HCI-Lab-Saarland/Print-A-Sketch/3d-print/3mf/case_CAMERABOARD.3mf

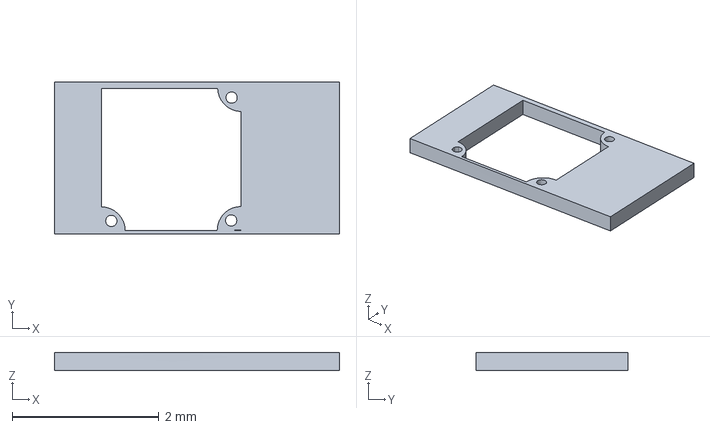
[picture p1: CAD file, 2022-02-14]
3d-print/3mf/case_CAMERABOARD.3mf
3.88 x 2.07 x 0.25 mm
