HCI-Lab-Saarland/Print-A-Sketch/3d-print/UMS5_PrintSettings_Case_final.3mf

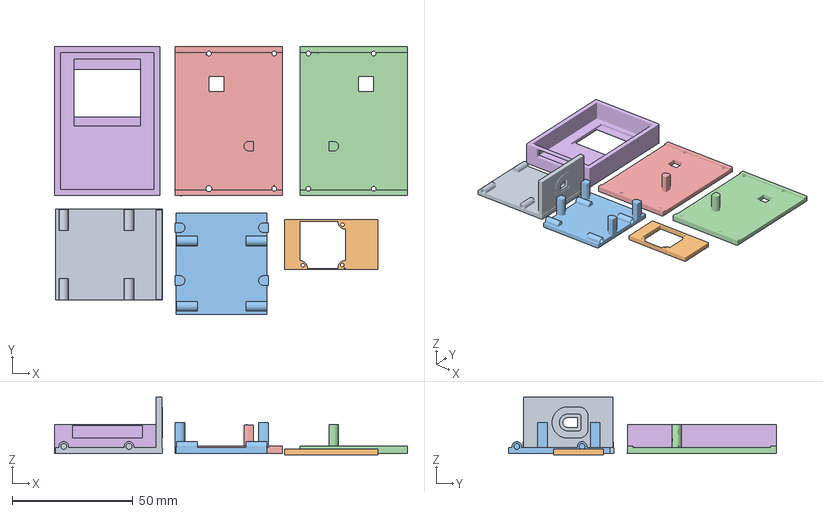
[picture p2: CAD file, 2022-02-14]
3d-print/UMS5_PrintSettings_Case_final.3mf
146.2 x 111.1 x 23.9 mm
objectprinter_BACK_repaired.3mf
objectprinter_CAMERABOARD_repaired.3mf
objectprinter_FRONT_repaired.3mf
objectprinter_RIGHT_repaired.3mf
objectprinter_LEFT_repaired.3mf
objectprinter_TOP_repaired.3mf
