HCI-Lab-Saarland/Print-A-Sketch/3d-print/3mf/case_TOP.3mf

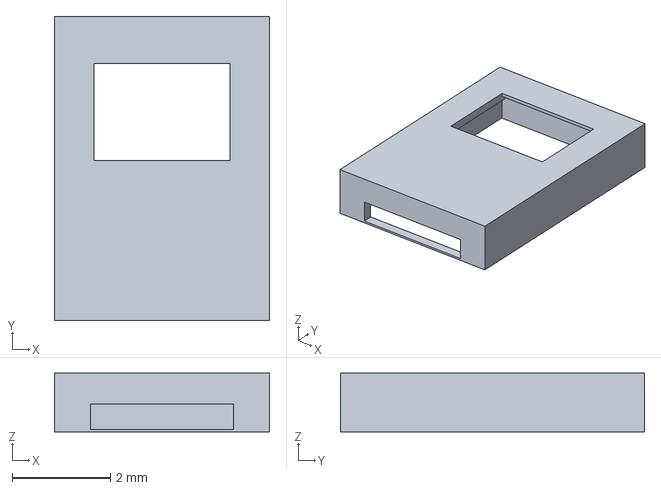
[picture p3: CAD file, 2022-02-14]
3d-print/3mf/case_TOP.3mf
4.37 x 6.18 x 1.20 mm
