HCI-Lab-Saarland/Print-A-Sketch/3d-print/UMS5_PrintSettings_HandRest_final.3mf

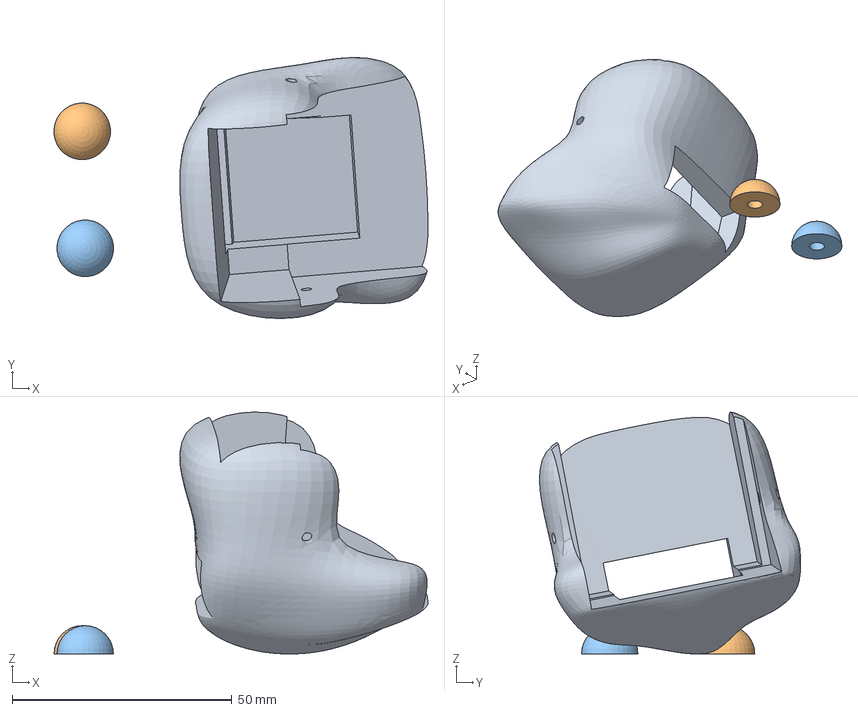
[picture p4: CAD file, 2022-02-14]
3d-print/UMS5_PrintSettings_HandRest_final.3mf
85.2 x 59.5 x 55.1 mm
objectprinter_topscap_V003_repaired.3mf
objectprinter_buttons_V007_repaired.3mf
objectprinter_buttons_V007_repaired.3mf(1)
