HCI-Lab-Saarland/Print-A-Sketch/3d-print/3mf/case_RIGHT.3mf

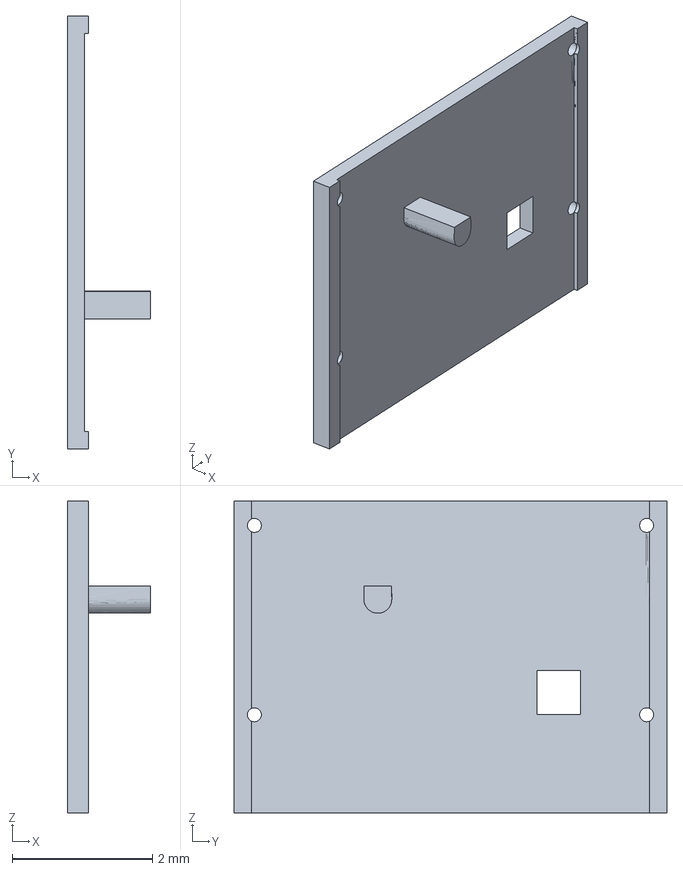
[picture p5: CAD file, 2022-02-14]
3d-print/3mf/case_RIGHT.3mf
1.19 x 6.18 x 4.45 mm
