HCI-Lab-Saarland/Print-A-Sketch/3d-print/3mf/case_BACK.3mf

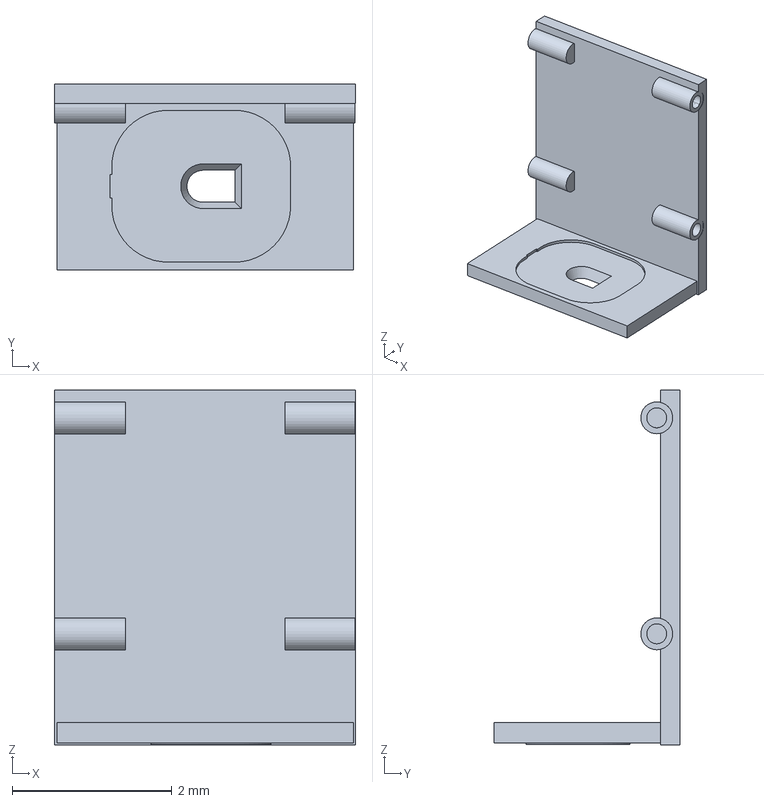
[picture p6: CAD file, 2022-02-14]
3d-print/3mf/case_BACK.3mf
3.77 x 2.33 x 4.44 mm
