HCI-Lab-Saarland/Print-A-Sketch/3d-print/3mf/buttons.3mf

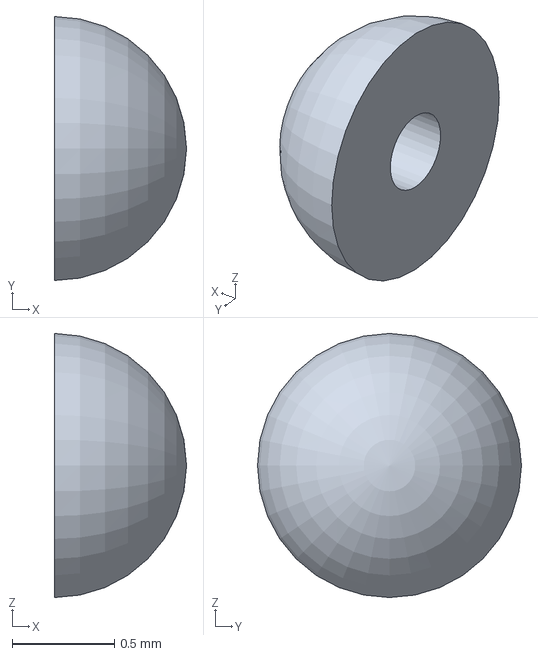
[picture p7: CAD file, 2022-02-14]
3d-print/3mf/buttons.3mf
0.646 x 1.29 x 1.29 mm
