HCI-Lab-Saarland/Print-A-Sketch/3d-print/3mf/handrest.3mf

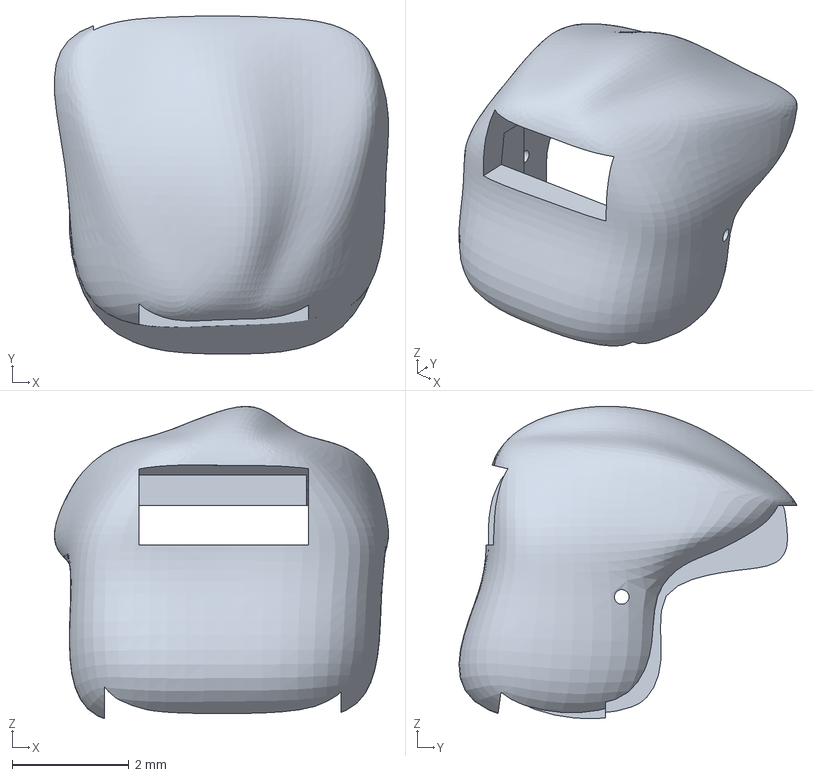
[picture p8: CAD file, 2022-02-14]
3d-print/3mf/handrest.3mf
5.72 x 5.78 x 5.34 mm
