HCI-Lab-Saarland/Print-A-Sketch/3d-print/3mf/case_FRONT.3mf

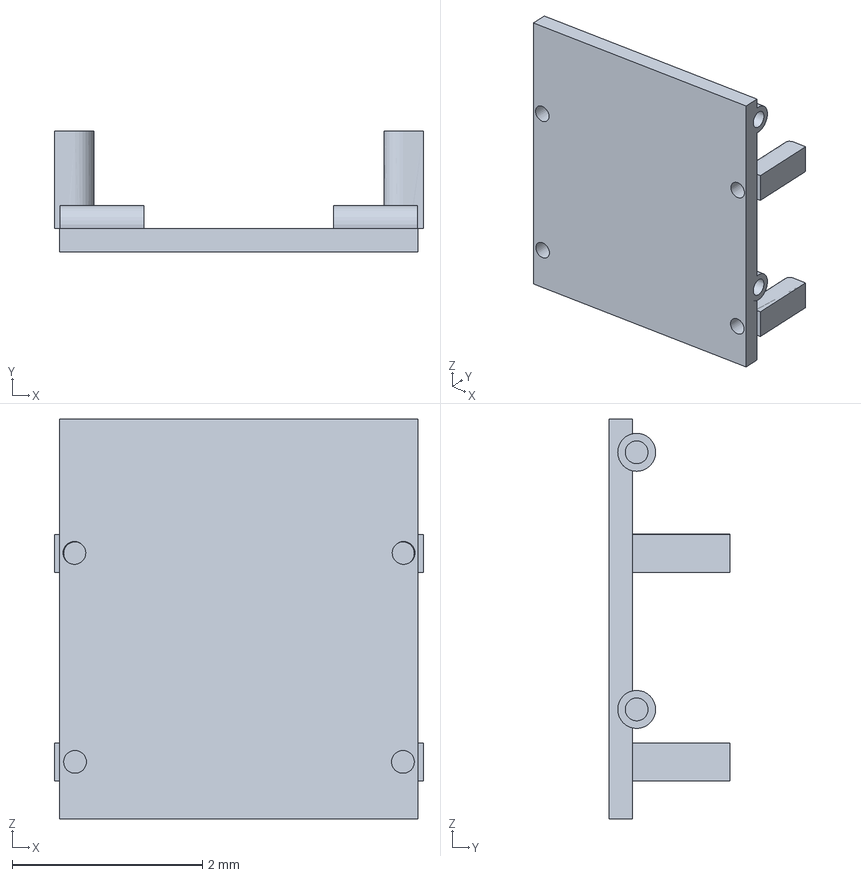
[picture p9: CAD file, 2022-02-14]
3d-print/3mf/case_FRONT.3mf
3.88 x 1.27 x 4.21 mm
