HCI-Lab-Saarland/Print-A-Sketch/(list of files, cad)

Other CAD files:
3d-print/3mf/case_LEFT.3mf
