HCI-Lab-Saarland/Print-A-Sketch/Print-A-Sketch_Schematic.png

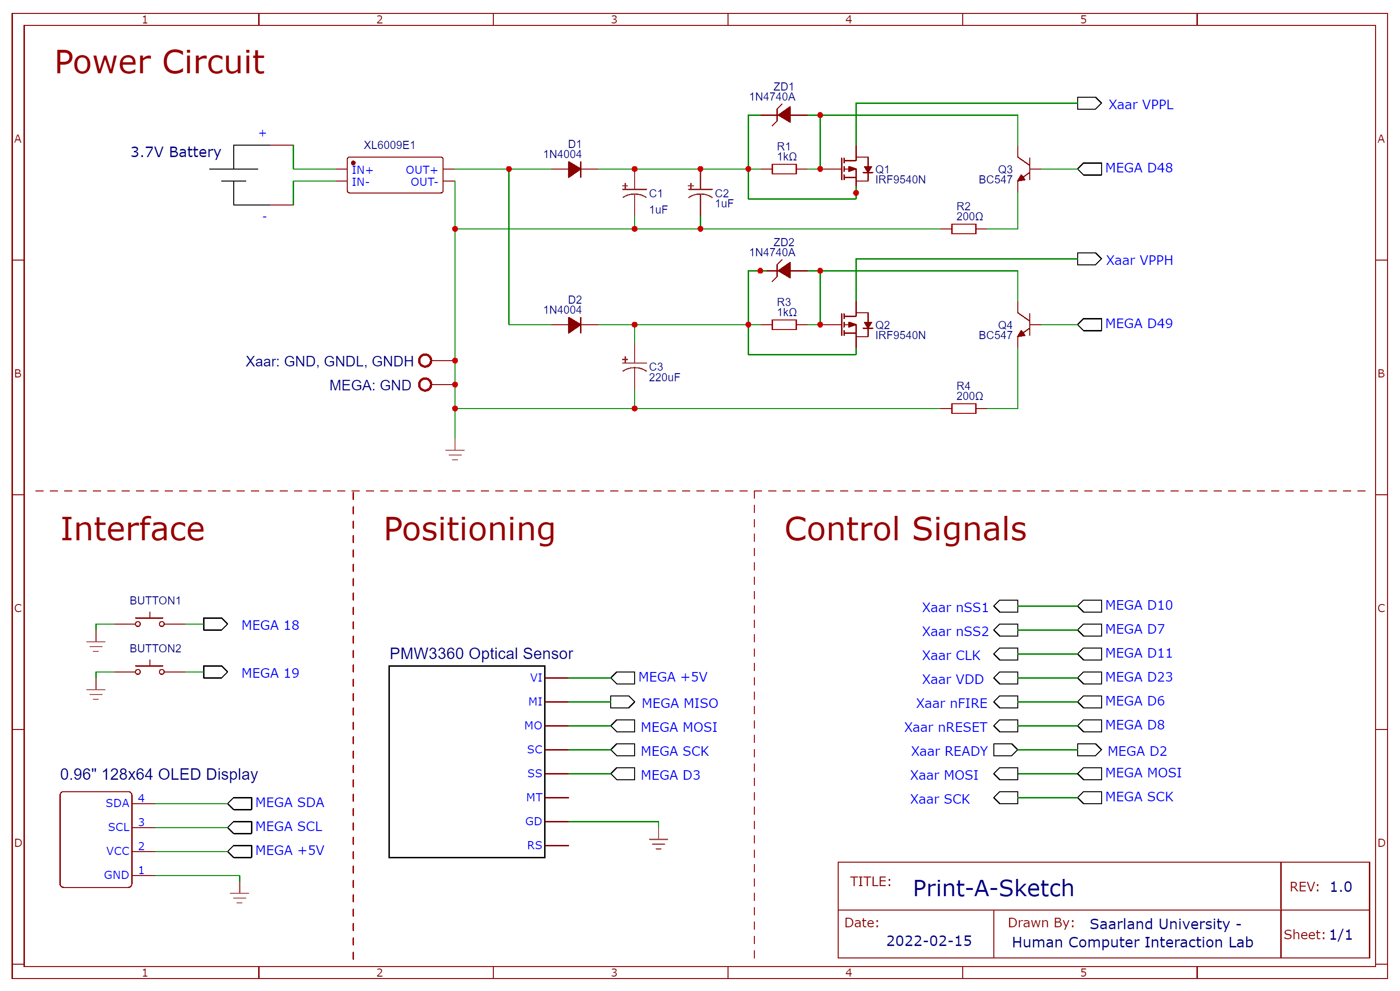
Print-A-Sketch_Schematic.png
