HCI-Lab-Saarland/Print-A-Sketch/supplemental material/print-a-sketch_backend/res/CHI.jpeg

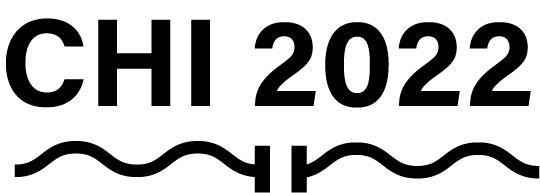
supplemental material/print-a-sketch_backend/res/CHI.jpeg
