HCI-Lab-Saarland/Print-A-Sketch/supplemental material/print-a-sketch_backend/res/sensor_1.png

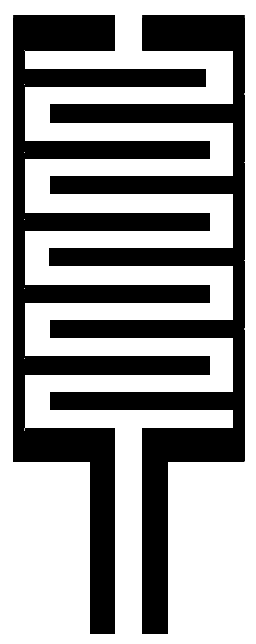
supplemental material/print-a-sketch_backend/res/sensor_1.png
