HCI-Lab-Saarland/Print-A-Sketch/print-a-sketch/pixel_data.h

#ifndef PIXEL_DATA_H_
#define PIXEL_DATA_H_

#define COLS 96

//hardcoded data for printing lines of width 8, 16, 32, 64, 128 (nozzles firing). First bit of first byte - nozzle 128, last bit of last byte - nozzle 1
static const byte width_8[16]  PROGMEM = {0b00000000,0b00000000,0b00000000,0b00000000,0b00000000,0b00000000,0b00000000,0b00001111,0b11110000,0b00000000,0b00000000,0b00000000,0b00000000,0b00000000,0b00000000,0b00000000};
static const byte width_16[16] PROGMEM = {0b00000000,0b00000000,0b00000000,0b00000000,0b00000000,0b00000000,0b00000000,0b11111111,0b11111111,0b00000000,0b00000000,0b00000000,0b00000000,0b00000000,0b00000000,0b00000000};
static const byte width_32[16] PROGMEM = {0b00000000,0b00000000,0b00000000,0b00000000,0b00000000,0b00000000,0b11111111,0b11111111,0b11111111,0b11111111,0b00000000,0b00000000,0b00000000,0b00000000,0b00000000,0b00000000};
static const byte width_64[16] PROGMEM = {0b00000000,0b00000000,0b00000000,0b00000000,0b11111111,0b11111111,0b11111111,0b11111111,0b11111111,0b11111111,0b11111111,0b11111111,0b00000000,0b00000000,0b00000000,0b00000000};
static const byte width_128[16]PROGMEM = {0b11111111,0b11111111,0b11111111,0b11111111,0b11111111,0b11111111,0b11111111,0b11111111,0b11111111,0b11111111,0b11111111,0b11111111,0b11111111,0b11111111,0b11111111,0b11111111};

//hardcoded data to print an image
static const byte PATTERN1[COLS][8] PROGMEM = {
//127-64, 63-0 
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
   {0b00000000,0b11111111,0b11111111,0b11111111,0b00000000,0b00000000,0b11111111,0b11111111},{0b11111111,0b11111111,0b00000000,0b00000000,0b11111111,0b11111111,0b11111111,0b00000000},
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
};


#endif
