HCI-Lab-Saarland/Print-A-Sketch/(commit log)

2022-02-14 3D files and print settings for Ultimaker S5
    Includes print settings for PLA (case) and TPU/PVA (handrest) to be loaded by Cura.
    [UMS5_PrintSettings_Case_final.3mf, UMS5_PrintSettings_HandRest_final.3mf]
2022-02-14 Individual 3D files for case, buttons and handrest.
    [buttons.3mf, case_BACK.3mf, case_CAMERABOARD.3mf, case_FRONT.3mf, case_LEFT.3mf, case_RIGHT.3mf, case_TOP.3mf, handrest.3mf]
2022-03-03 Rename supplemental material/print-a-sketch_backend/dataProcessing.py to supplemental material/print-a-sketch_backend/src/dataProcessing.py
2022-03-03 Rename supplemental material/print-a-sketch_backend/encoding.py to supplemental material/print-a-sketch_backend/src/encoding.py
2022-03-03 Rename supplemental material/print-a-sketch_backend/imageProcessing.py to supplemental material/print-a-sketch_backend/src/imageProcessing.py
2022-03-03 Rename supplemental material/print-a-sketch_backend/main.py to supplemental material/print-a-sketch_backend/src/main.py
2022-03-03 Rename supplemental material/print-a-sketch_backend/popup.py to supplemental material/print-a-sketch_backend/src/popup.py
2022-03-03 Rename supplemental material/print-a-sketch_backend/port.py to supplemental material/print-a-sketch_backend/src/port.py
2022-03-03 Rename supplemental material/print-a-sketch_backend/printer.kv to supplemental material/print-a-sketch_backend/src/printer.kv
2022-03-03 Rename supplemental material/print-a-sketch_backend/requirements.txt to supplemental material/print-a-sketch_backend/src/requirements.txt
2022-03-03 Rename supplemental material/print-a-sketch_backend/statvar.py to supplemental material/print-a-sketch_backend/src/statvar.py
